mvsivaselvan/CIE324-Swing-Project/IMUtest/BNO055-Iphone-Comarison-setup.jpg

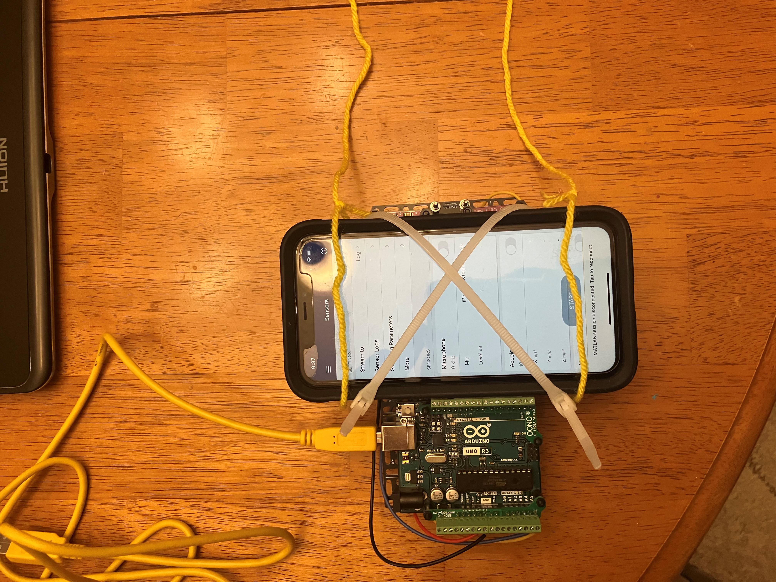
IMUtest/BNO055-Iphone-Comarison-setup.jpg
