mvsivaselvan/CIE324-Swing-Project/calibration/LoadCellCalibrationSetup.jpg

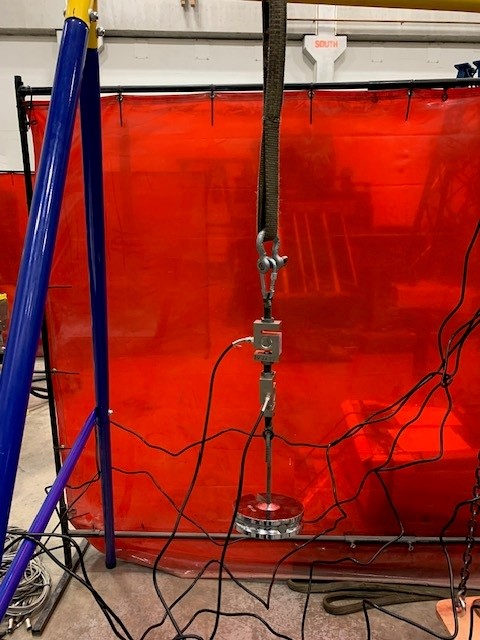
calibration/LoadCellCalibrationSetup.jpg
