mvsivaselvan/CIE324-Swing-Project/doc/SwingSystemWiringDiagram.pdf

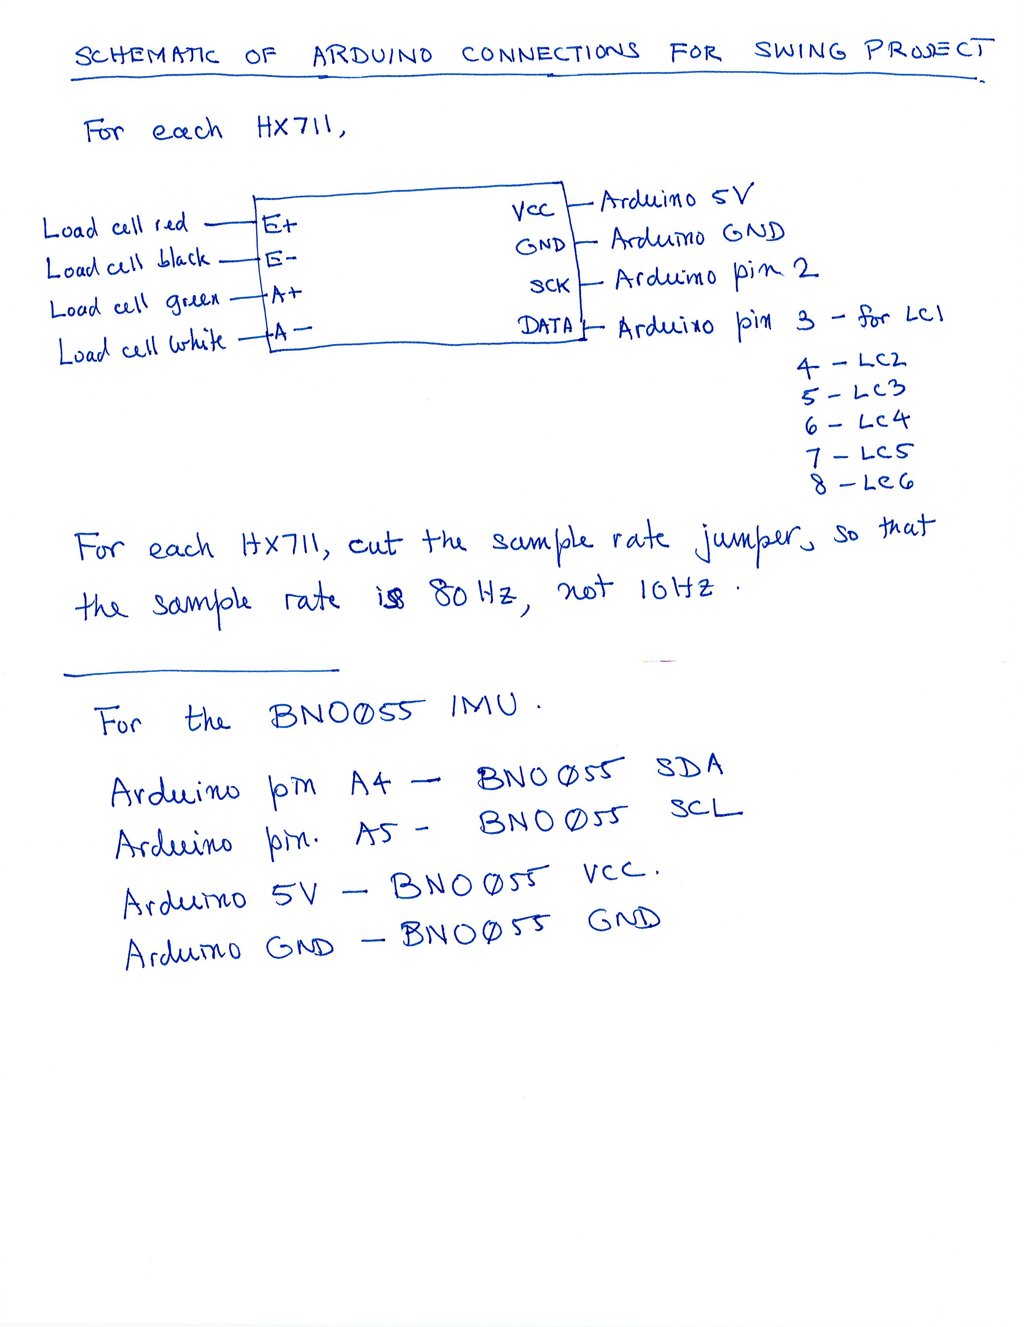
[picture p3: page 1]
