mvsivaselvan/CIE324-Swing-Project/calibration/LoadCellCalibrationData.txt

23682,-0.31,0.38,9.44,0.00,0.12,0.00,359.94,-1.69,-2.38,5864,12464,-33033,-33144,-33468,-34500
23780,-0.26,0.40,9.47,-0.06,0.00,0.00,359.94,-1.69,-2.38,5780,12470,-33077,-33095,-33389,-34503
23880,-0.25,0.37,9.47,-0.06,0.06,0.06,359.94,-1.69,-2.38,5815,12437,-32912,-32964,-33374,-34512
23981,-0.30,0.36,9.47,-0.06,0.12,0.00,359.94,-1.69,-2.38,5723,12470,-32965,-33129,-33315,-34690
24080,-0.27,0.39,9.46,0.06,0.00,-0.06,359.94,-1.69,-2.38,5583,12420,-32876,-33120,-33530,-34417
24180,-0.29,0.37,9.47,0.06,0.00,-0.06,359.94,-1.69,-2.38,5768,12490,-32854,-33070,-33466,-34348
24281,-0.25,0.38,9.43,0.12,0.00,0.12,359.94,-1.69,-2.38,5789,12398,-32612,-32975,-33242,-34403
24380,-0.28,0.40,9.42,-0.19,0.00,0.06,359.94,-1.69,-2.38,5750,12452,-32635,-32792,-33172,-34536
24480,-0.30,0.41,9.42,-0.06,0.25,-0.06,359.94,-1.69,-2.38,5826,-8382382,-32658,-33122,-33276,-34376
24581,-0.26,0.36,9.48,-0.12,0.06,0.06,359.94,-1.69,-2.38,5793,12281,-32704,-33077,-33260,-34244
24681,-0.30,0.41,9.48,0.06,-0.06,0.00,359.94,-1.69,-2.38,5798,12596,-32780,-33147,-33162,-34365
24781,-0.27,0.36,9.48,0.06,-0.06,-0.06,359.94,-1.69,-2.38,5622,12404,-32907,-32959,-33430,-34699
24882,-0.26,0.41,9.46,0.00,0.00,0.06,359.94,-1.69,-2.38,5828,12414,-33104,-33316,-33081,-34497
24982,-0.28,0.40,9.46,0.00,-0.12,0.06,359.94,-1.69,-2.38,5662,12479,-33109,-33252,-33497,-34410
25082,-0.22,0.33,9.49,-0.06,-0.25,0.06,359.94,-1.69,-2.38,5823,12541,-33113,-33096,-33365,-34550
25183,-0.27,0.39,9.43,-0.06,-0.25,0.06,359.94,-1.69,-2.38,5882,12499,-32897,-32895,-33232,-34486
25283,-0.19,0.40,9.44,-0.12,0.06,0.06,359.94,-1.69,-2.38,5841,12422,-32343,-32171,-32832,-34189
25383,-0.42,0.35,9.40,0.00,0.25,0.06,359.94,-1.69,-2.38,5834,12495,-31373,-31865,-32579,-33875
25482,-0.13,0.46,9.48,0.12,0.31,-0.06,359.94,-1.69,-2.38,5836,12512,-30623,-31587,-32551,-33734
25582,-0.33,0.36,9.45,0.19,0.37,-0.19,359.94,-1.69,-2.38,5896,12336,-30613,-31480,-32429,-33567
25682,-0.28,0.33,9.52,0.06,0.25,-0.06,359.94,-1.69,-2.38,5686,12483,-30390,-31479,-32359,-33665
25780,-0.22,0.45,9.53,0.19,0.06,-0.06,359.94,-1.69,-2.38,5785,12425,-30780,-31709,-32503,-33717
25880,-0.31,0.22,9.48,0.12,-0.12,0.00,359.94,-1.69,-2.38,5770,12579,-31349,-31987,-32752,-33886
25980,-0.23,0.45,9.41,0.00,-0.12,0.06,359.94,-1.69,-2.38,5812,12576,-31574,-32150,-32890,-33926
26080,-0.34,0.46,9.35,0.06,-0.06,-0.06,359.94,-1.69,-2.38,5836,12450,-31272,-32231,-32693,-34172
26181,-0.26,0.32,9.40,-0.12,0.06,0.00,359.94,-1.69,-2.38,5795,12417,-31797,-32585,-32962,-33971
26281,-0.23,0.42,9.40,-0.06,-0.12,0.06,359.94,-1.69,-2.38,5799,12480,-32058,-32650,-33091,-34644
26381,-0.33,0.40,9.44,0.06,0.12,-0.06,359.94,-1.69,-2.38,5766,12515,-31995,-32603,-32847,-34132
26481,-0.23,0.34,9.44,0.06,0.00,-0.06,359.94,-1.69,-2.38,5920,12414,-32458,-32870,-33225,-34396
26583,-0.28,0.40,9.41,0.00,0.06,0.00,359.94,-1.69,-2.38,5636,12503,-33191,-32961,-33297,-34445
26682,-0.31,0.38,9.42,0.12,-0.06,0.12,359.94,-1.69,-2.38,5782,12545,-33659,-33056,-33195,-34346
26782,-0.22,0.39,9.44,0.00,0.00,0.06,359.94,-1.69,-2.38,5755,12421,-33826,-33276,-33349,-34398
26884,-0.30,0.42,9.45,-0.12,0.06,0.06,359.94,-1.69,-2.38,5839,12479,-33674,-33432,-33583,-34818
26983,-0.29,0.40,9.45,0.00,0.06,0.00,359.94,-1.69,-2.38,5724,12489,-34047,-33599,-33800,-34914
27083,-0.25,0.39,9.47,-0.12,0.19,0.00,359.94,-1.69,-2.38,5672,12301,-33699,-33558,-33837,-34716
27183,-0.31,0.40,9.45,0.06,-0.25,0.06,359.94,-1.69,-2.38,5847,12476,-33630,-33536,-33658,-34853
27281,-0.26,0.42,9.44,0.00,0.00,0.06,359.94,-1.69,-2.38,5725,12379,-33328,-33543,-33574,-34961
27381,-0.26,0.36,9.44,0.06,0.12,0.06,359.94,-1.69,-2.38,5841,12434,-33638,-33460,-33740,-34914
27481,-0.30,0.38,9.45,-0.06,0.06,0.19,359.94,-1.69,-2.38,5852,12404,-33590,-33555,-33679,-34970
27580,-0.25,0.41,9.47,-0.06,0.12,0.00,359.94,-1.69,-2.38,5789,12443,-33555,-33456,-33812,-34837
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
