mvsivaselvan/CIE324-Swing-Project/(commit log)

2024-01-10 Tested swing_measure.ino with two load cell channels with Arduino IDE Serial monitor and Serial plotter
2024-01-11 Added MATLAB code to acquire data from Arduino by serial communication
    (1) swing.ino was modified to put CRLF at the end of each line so that this
    can be used as the terminator in MATLAB's serial read
    (2) readArduino is the call back that reads serial port and accumulates
    data
    (3) swing_DAQ is written to acquire a fixed number of samples
    [swing_measure.ino]
2024-01-11 Added MATLAB app for data acquisition from the Arduino
    1. SwingApp is the GUI
    2. readArduino is the callback to accumulate data from the serial port
    3. There is an AcquiredDataBlock event in SwingApp that is triggered
    by readArduino whenever a block of data of a specified size had been
    acquired
    4. plotAcquiredData is the listener callback for this even, and plot in
    the axis in the SwingApp GUI
2024-01-11 Added IMU to swing_measure.ino, just reading acceleration components for now
2024-01-16 Added checkboxes in the GUI, and modified plotAquiredData callback accordingly to select plots to display, at this stage only 3 accel channels (1, 2, 3) and 2 load cell channels (10, 11); 4--9 are re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
2024-01-22 Added load cell calibration data and code
2024-01-22 Arduino code and MATLAB GUI updated to acquire all 15 channels
2024-02-10 Measure BNO055 timing; implemented load time using millis instead of delay
2024-02-11 Data collected to compare BNO055 and Iphone IMUs
    1. Data files
    2. Script to generate comparison plots
    3. Photo of setup
    4. Angular velocity compares very well, BNO055 orientation seems to have
    some drift compared to Iphone, Z accelerations generally track, but
    aren't exactly the same (maybe because radius of swinging is
    different).
2024-02-14 Calibrated load cells with finalized DAQ in Ketter 133 setup; added new data file for this
2024-02-16 updated SwingDAQ.mlapp with 11520 baud rate and to accommodate the first channel being millis
2025-03-20 Added wiring diagram
